noorilpsp/pathfinder/fly.jpg

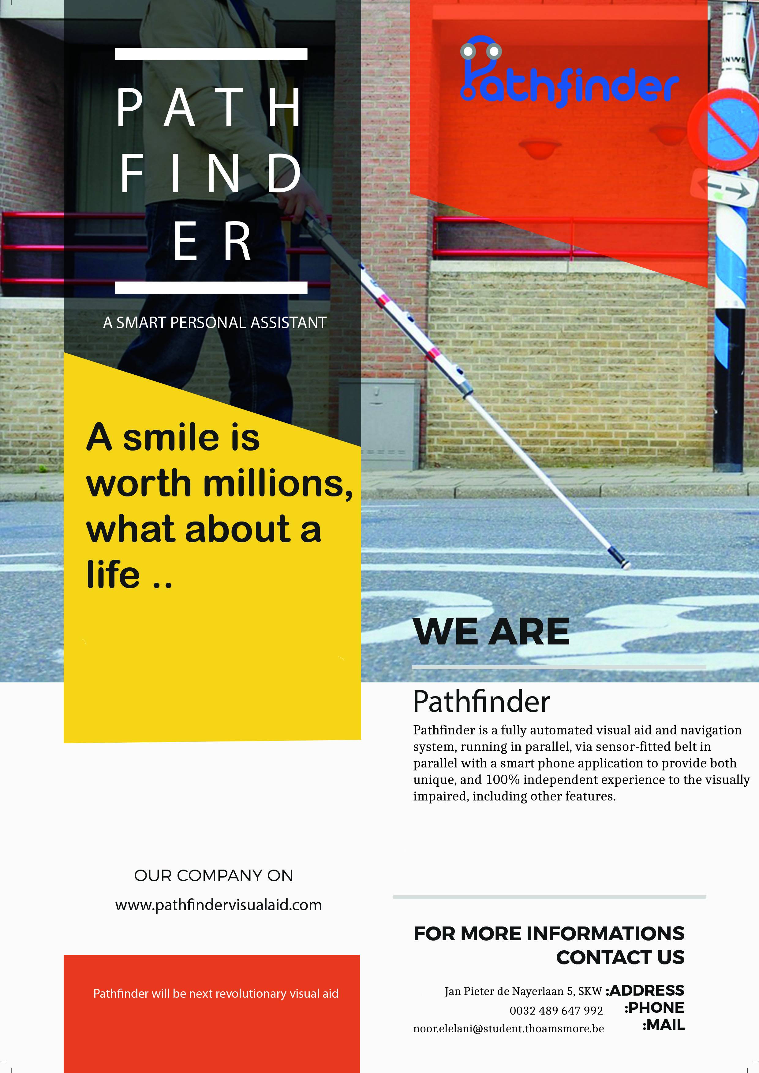
fly.jpg
