noorilpsp/pathfinder/soft.png

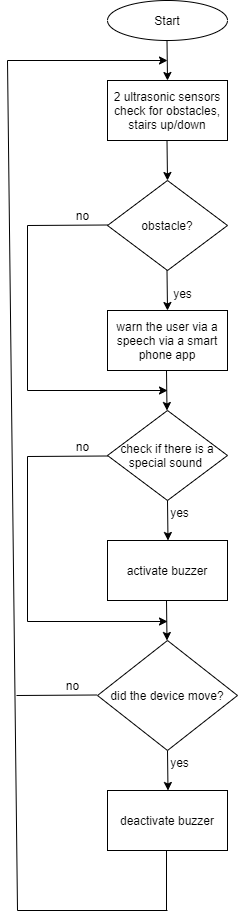
soft.png
