noorilpsp/pathfinder/pathfinder.brd

## EAGLE design pathfinder.brd (2020-05-18)

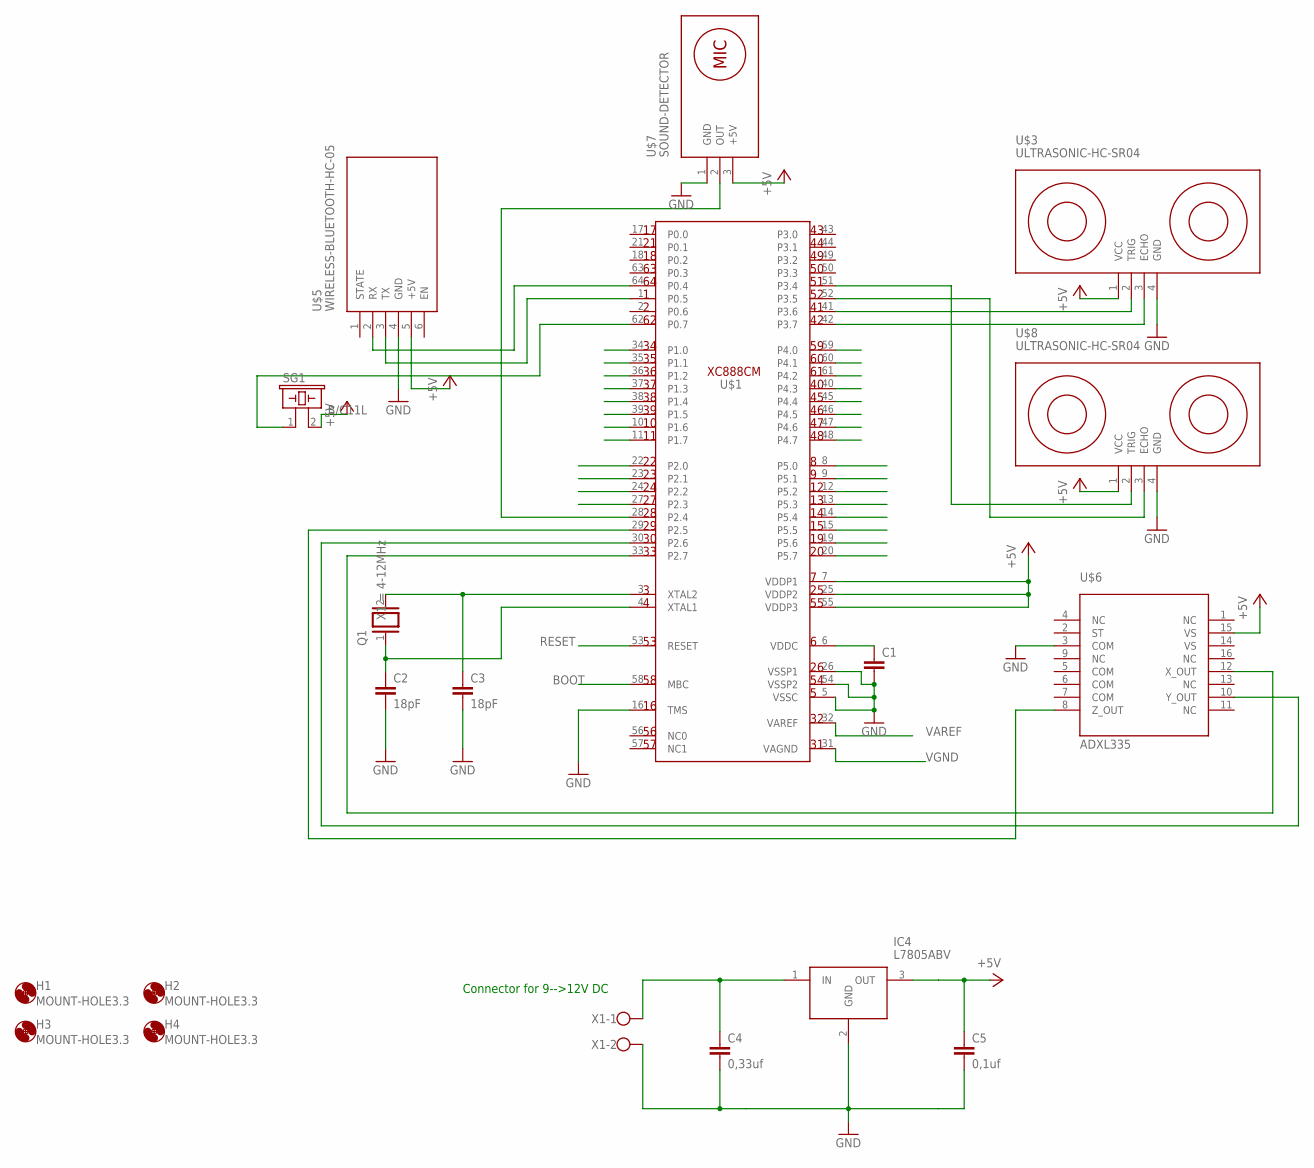
[picture p18: schematic pathfiner.sch]

Parts:
C1: C2,5-3; C2.5-3
C2, C3: 18pF; C2.5-3
C4: 0,33uf; C025-030X050
C5: 0,1uf; C025-030X050
H1, H2, H3, H4: MOUNT-HOLE3.3; 3,3
IC4: L7805ABV; TO270P460X1020X2008-3P
Q1: XTAL; Q
SG1: B/C11L
U$1: XC888; QFP50P1200X1200X160-64N
U$3, U$8: ULTRASONIC-HC-SR04
U$5: WIRELESS-BLUETOOTH-HC-05
U$6: ADXL335; LFCSP16
U$7: SOUND-DETECTOR
X1: W237-102

Connections:
+5V: C5.1, IC4.3 (OUT), SG1.2, U$1.7 (VDDP1), U$1.25 (VDDP2), U$1.55 (VDDP3), U$3.1 (VCC), U$5.5 (+5V), U$6.15 (VS), U$7.3 (+5V), U$8.1 (VCC)
BOOT: U$1.58 (MBC)
GND: C1.2, C2.2, C3.2, C4.2, C5.2, IC4.2 (GND), U$1.5 (VSSC), U$1.16 (TMS), U$1.26 (VSSP1), U$1.54 (VSSP2), U$3.4 (GND), U$5.4 (GND), U$6.3 (COM), U$7.1 (GND), U$8.4 (GND), X1.2
unnamed: U$1.33 (P2.7), U$6.12 (X_OUT)
unnamed: U$1.28 (P2.4), U$7.2 (OUT)
unnamed: U$1.29 (P2.5), U$6.8 (Z_OUT)
unnamed: C4.1, IC4.1 (IN), X1.1
unnamed: SG1.1, U$1.62 (P0.7)
unnamed: U$1.1 (P0.5), U$5.3 (TX)
unnamed: U$1.64 (P0.4), U$5.2 (RX)
unnamed: U$1.52 (P3.5), U$8.3 (ECHO)
unnamed: U$1.41 (P3.6), U$3.2 (TRIG)
unnamed: U$1.42 (P3.7), U$3.3 (ECHO)
unnamed: C3.1, Q1.2, U$1.3 (XTAL2)
unnamed: C2.1, Q1.1, U$1.4 (XTAL1)
unnamed: C1.1, U$1.6 (VDDC)
unnamed: U$1.51 (P3.4), U$8.2 (TRIG)
unnamed: U$1.30 (P2.6), U$6.10 (Y_OUT)
RESET: U$1.53 (RESET)
VAREF: U$1.32 (VAREF)
VGND: U$1.31 (VAGND)

Notes on the sheet:
Connector for 9-->12V DC

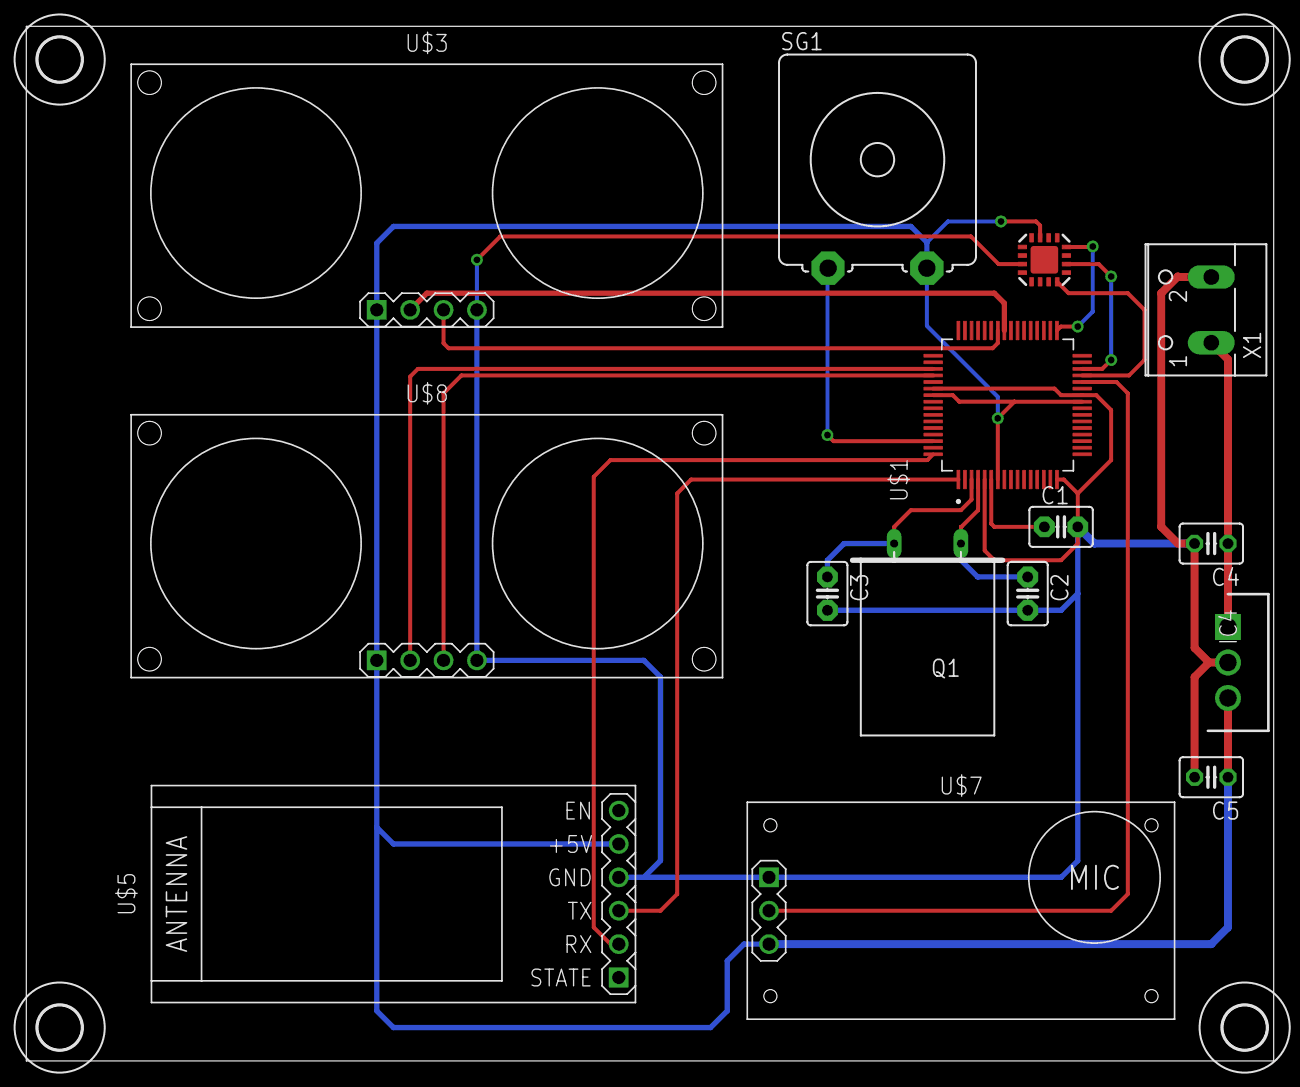
[picture p19: board pathfinder.brd from above]

Board: 2 copper layers, 94.9 x 78.7 mm, 19 parts (0 on the bottom side), 17 nets.
