noorilpsp/pathfinder/user manual.docx

User manual:
